UCSD-Quadcopter-Class/quad-hardware-bgmdt/quadcopter.brd

## EAGLE design quadcopter.brd (2017-05-23)

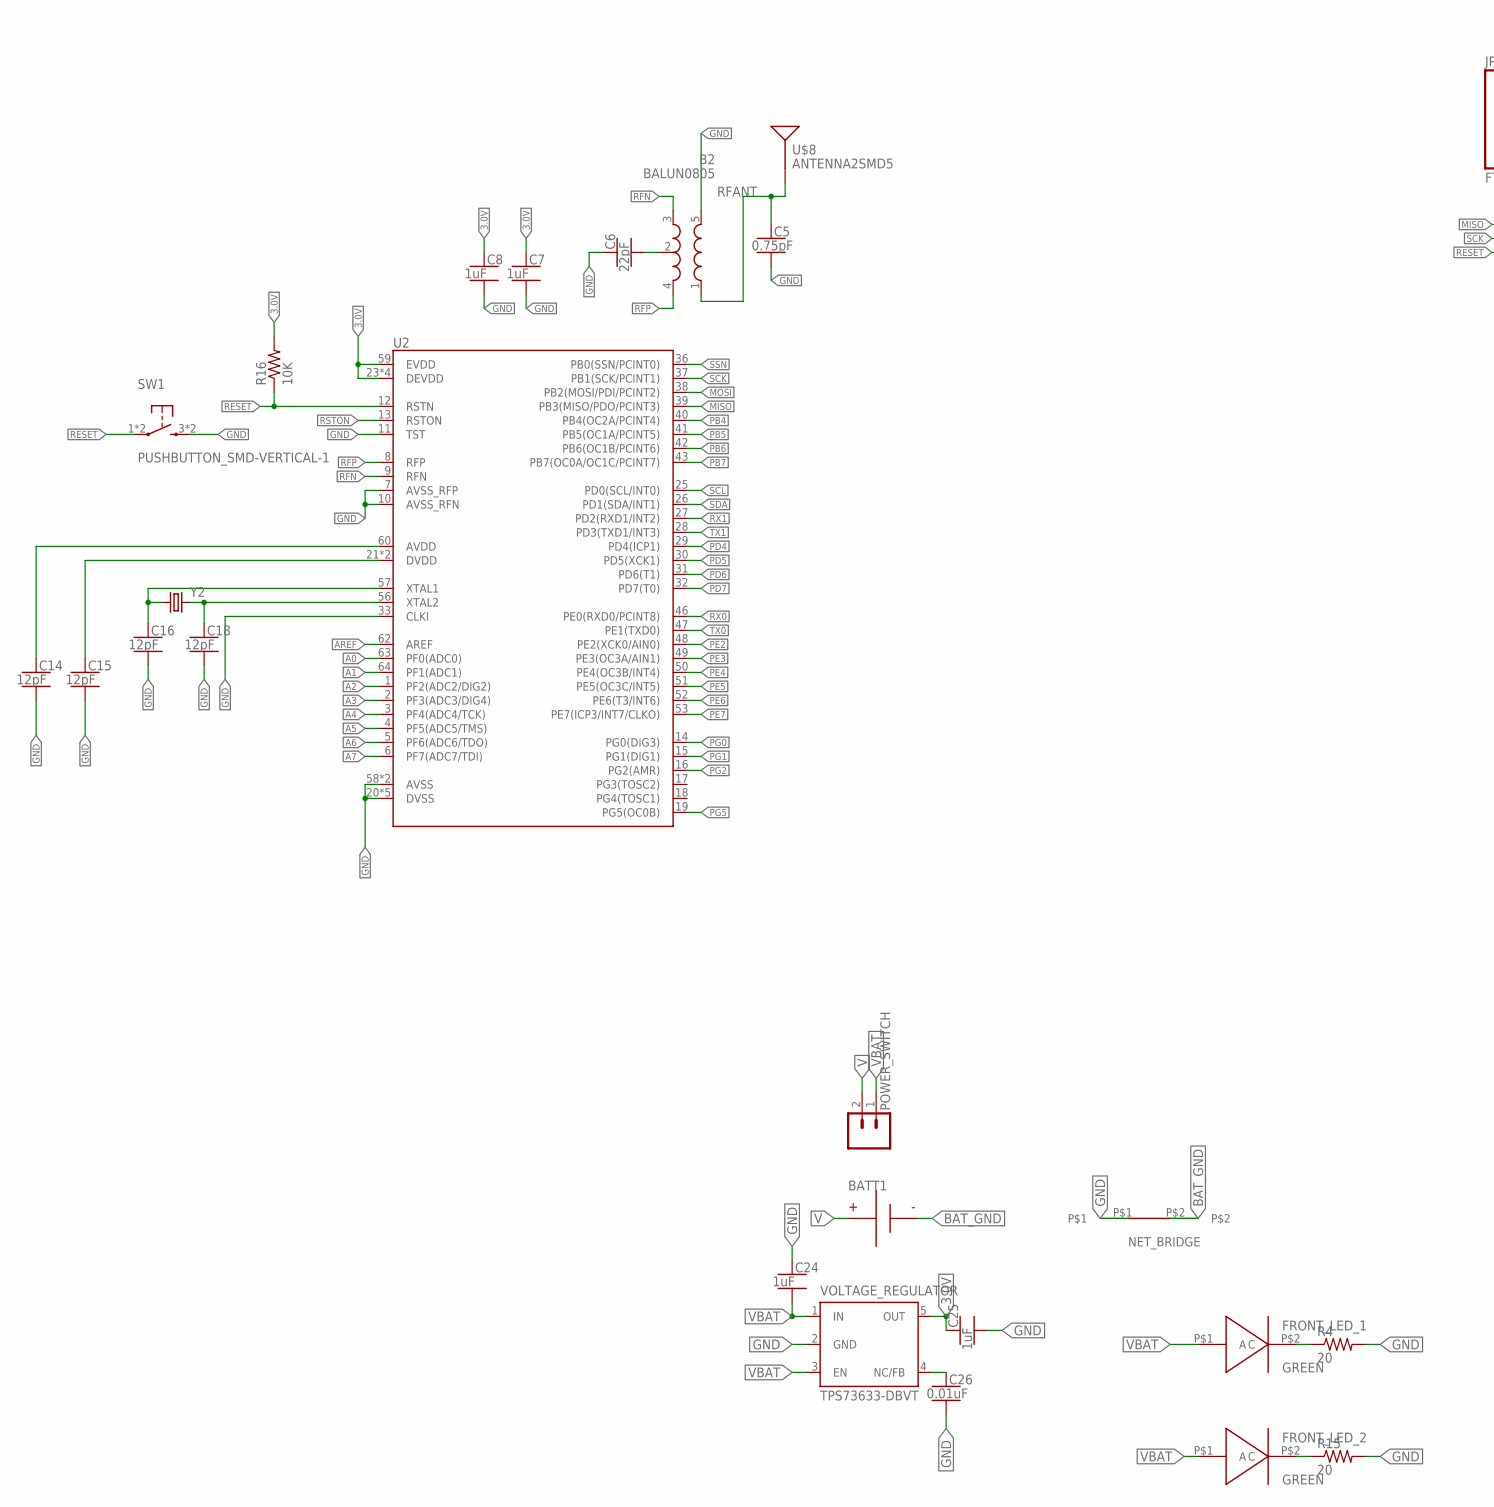
[picture p1: schematic quadcopter.sch, part in row 1, column 1]

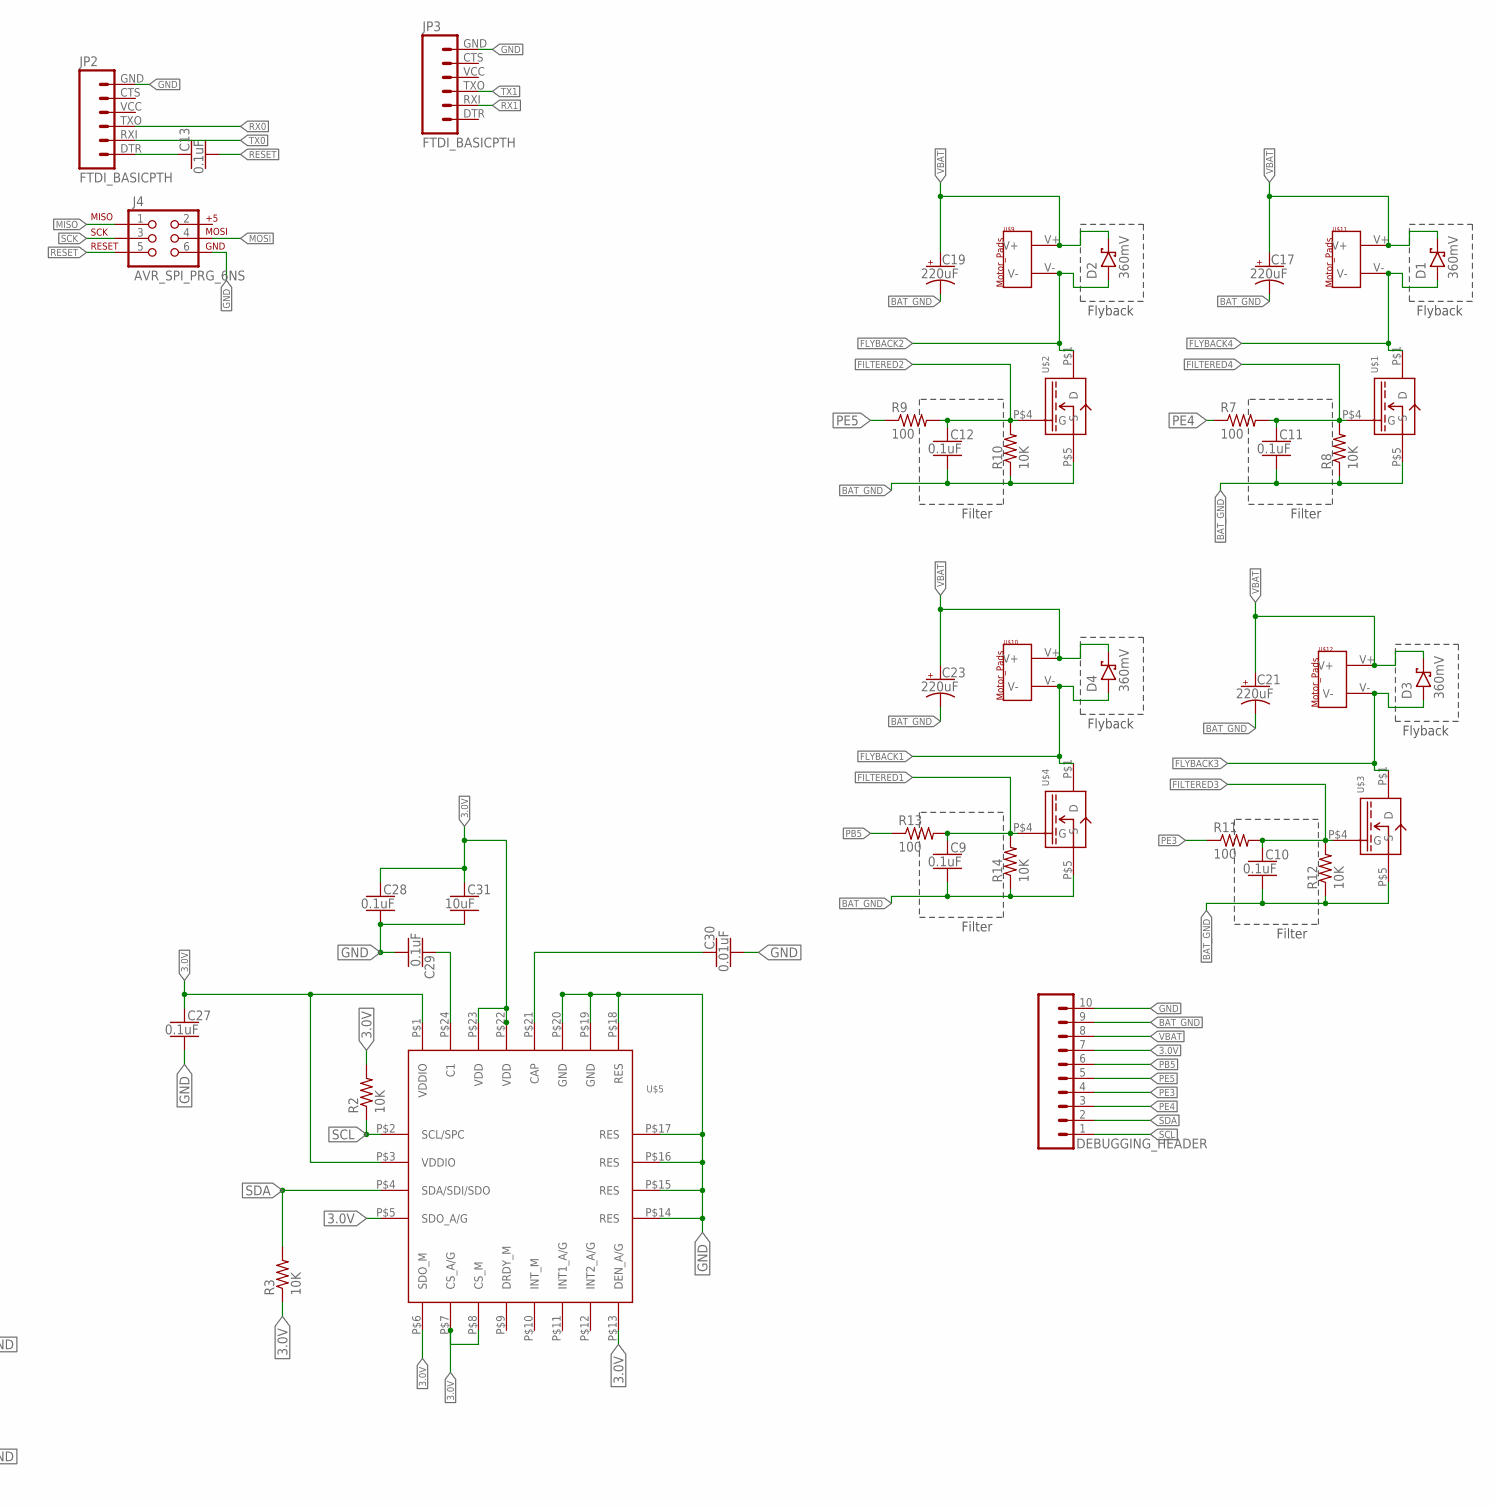
[picture p2: schematic quadcopter.sch, part in row 1, column 2]

Parts:
B2: BALUN0805; BALUN
BATT1: BATTERY-HUBSAN-W/HOLDER; BATTERY-W/HOLDER-380MAH-HUBSAN
C5: 0.75pF; CAPC2012X140_HS
C6: 22pF; CAPC2012X140_HS
C7, C8, C24, C25: 1uF; CAPC2012X140_HS
C9, C10, C11, C12, C13, C27, C28, C29: 0.1uF; CAPC2012X140_HS
C14, C15, C16, C18: 12pF; CAPC2012X140_HS
C17, C19, C21, C23: 220uF; CAPMP7343X310_HS
C26, C30: 0.01uF; CAPC2012X140_HS
C31: 10uF; CAPC2012X140_HS
D1, D2, D3, D4: 360mV; SOD3716X135_HS
DEBUGGING_HEADER: SIP-10_TH-254X10-1; HDRV10W63P254_10X1_2540X254H838_HS
FRONT_LED_1, FRONT_LED_2: GREEN; KINGBRIGHT_LED
J4: AVR_SPI_PRG_6NS; 2X3-NS
JP2, JP3: FTDI_BASICPTH; FTDI_BASIC
NET_BRIDGE: NET_BRIDGE
POWER_SWITCH: MALE_HEADER_2POS-2X1-0.1IN; MALE_HEADER_2X1_0.1IN
R2, R3, R8, R10, R12, R14, R16: 10K; RESC2012X60_HS
R4, R15: 20; RESC2012X60_HS
R7, R9, R11, R13: 100; RESC2012X60_HS
SW1: PUSHBUTTON_SMD-VERTICAL-1; TE_FSM8JSMA_HS
U2: ATMEGA128RFA1; QFN-64
U$1, U$2, U$3, U$4: MOFSET_SI2302CDS-T1-E3CT-ND
U$5: IMU_497-14946-1-ND
U$8: ANTENNA2SMD5; ANTENNA-CHIP5
U$9, U$10, U$11, U$12: MOTOR_PADS
VOLTAGE_REGULATOR: TPS73633-DBVT; SOT23-DBV
Y2: CRYSTAL5X3; CRYSTAL-SMD-5X3

Connections:
3.0V: C7.1, C8.1, C25.1, C27.1, C28.1, C31.1, DEBUGGING_HEADER.7, R2.2, R3.1, R16.2, U2.23 (DEVDD), U2.34 (DEVDD), U2.44 (DEVDD), U2.54 (DEVDD), U2.59 (EVDD), U$5.P$1 (VDDIO), U$5.P$3 (VDDIO), U$5.P$5 (SDO_A/G), U$5.P$6 (SDO_M), U$5.P$7 (CS_A/G), U$5.P$8 (CS_M), U$5.P$13 (DEN_A/G), U$5.P$22 (VDD), U$5.P$23 (VDD), VOLTAGE_REGULATOR.5 (OUT)
A0: U2.63 (PF0(ADC0))
A1: U2.64 (PF1(ADC1))
A2: U2.1 (PF2(ADC2/DIG2))
A3: U2.2 (PF3(ADC3/DIG4))
A4: U2.3 (PF4(ADC4/TCK))
A5: U2.4 (PF5(ADC5/TMS))
A6: U2.5 (PF6(ADC6/TDO))
A7: U2.6 (PF7(ADC7/TDI))
AREF: U2.62 (AREF)
AVDD: C14.1, U2.60 (AVDD); also elsewhere on the board
DTR: C13.1, JP2.DTR (1)
DVDD: C15.1, U2.21 (DVDD), U2.22 (DVDD); also elsewhere on the board
FILTERED1: C9.1, R13.2, R14.2, U$4.P$4 (G)
FILTERED2: C12.1, R9.2, R10.2, U$2.P$4 (G)
FILTERED3: C10.1, R11.2, R12.2, U$3.P$4 (G)
FILTERED4: C11.1, R7.2, R8.2, U$1.P$4 (G)
FLYBACK1: D4.A, U$4.P$1 (D), U$10.V-
FLYBACK2: D2.A, U$2.P$1 (D), U$9.V-
FLYBACK3: D3.A, U$3.P$1 (D), U$12.V-
FLYBACK4: D1.A, U$1.P$1 (D), U$11.V-
MISO: J4.1, U2.39 (PB3(MISO/PDO/PCINT3))
MOSI: J4.4, U2.38 (PB2(MOSI/PDI/PCINT2))
unnamed: FRONT_LED_1.P$2 (C), R4.1
unnamed: C30.1, U$5.P$21 (CAP)
unnamed: FRONT_LED_2.P$2 (C), R15.1
unnamed: B2.2 (GND), C6.2
unnamed: C29.1, U$5.P$24 (C1)
unnamed: C16.1, U2.57 (XTAL1), Y2.1
unnamed: C18.1, U2.56 (XTAL2), Y2.3 (2)
unnamed: C26.1, VOLTAGE_REGULATOR.4 (NC/FB)
PB4: U2.40 (PB4(OC2A/PCINT4))
PB5: DEBUGGING_HEADER.6, R13.1, U2.41 (PB5(OC1A/PCINT5))
PB6: U2.42 (PB6(OC1B/PCINT6))
PB7: U2.43 (PB7(OC0A/OC1C/PCINT7))
PD4: U2.29 (PD4(ICP1))
PD5: U2.30 (PD5(XCK1))
PD6: U2.31 (PD6(T1))
PD7: U2.32 (PD7(T0))
PE2: U2.48 (PE2(XCK0/AIN0))
PE3: DEBUGGING_HEADER.4, R11.1, U2.49 (PE3(OC3A/AIN1))
PE4: DEBUGGING_HEADER.3, R7.1, U2.50 (PE4(OC3B/INT4))
PE5: DEBUGGING_HEADER.5, R9.1, U2.51 (PE5(OC3C/INT5))
PE6: U2.52 (PE6(T3/INT6))
PE7: U2.53 (PE7(ICP3/INT7/CLKO))
PG0: U2.14 (PG0(DIG3))
PG1: U2.15 (PG1(DIG1))
PG2: U2.16 (PG2(AMR))
PG5: U2.19 (PG5(OC0B))
RESET: C13.2, J4.5, R16.1, SW1.1, SW1.2 (1), U2.12 (RSTN)
RFANT: B2.1 (IN), C5.1, U$8.FEED
RFN: B2.3 (OUT2), U2.9 (RFN)
RFP: B2.4 (OUT1), U2.8 (RFP)
RSTON: U2.13 (RSTON)
RX0: JP2.TXO (3), U2.46 (PE0(RXD0/PCINT8))
SCK: J4.3, U2.37 (PB1(SCK/PCINT1))
SCL: DEBUGGING_HEADER.1, R2.1, U2.25 (PD0(SCL/INT0)), U$5.P$2 (SCL/SPC)
SDA: DEBUGGING_HEADER.2, R3.2, U2.26 (PD1(SDA/INT1)), U$5.P$4 (SDA/SDI/SDO)
SSN: U2.36 (PB0(SSN/PCINT0))
TX0: JP2.RXI (2), U2.47 (PE1(TXD0))
V: BATT1.+, POWER_SWITCH.2
VBAT: C17.1 (+), C19.1 (+), C21.1 (+), C23.1 (+), C24.2, D1.C, D2.C, D3.C, D4.C, DEBUGGING_HEADER.8, FRONT_LED_1.P$1 (A), FRONT_LED_2.P$1 (A), POWER_SWITCH.1, U$9.V+, U$10.V+, U$11.V+, U$12.V+, VOLTAGE_REGULATOR.1 (IN), VOLTAGE_REGULATOR.3 (EN)

Notes on the sheet:
Filter
Flyback

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
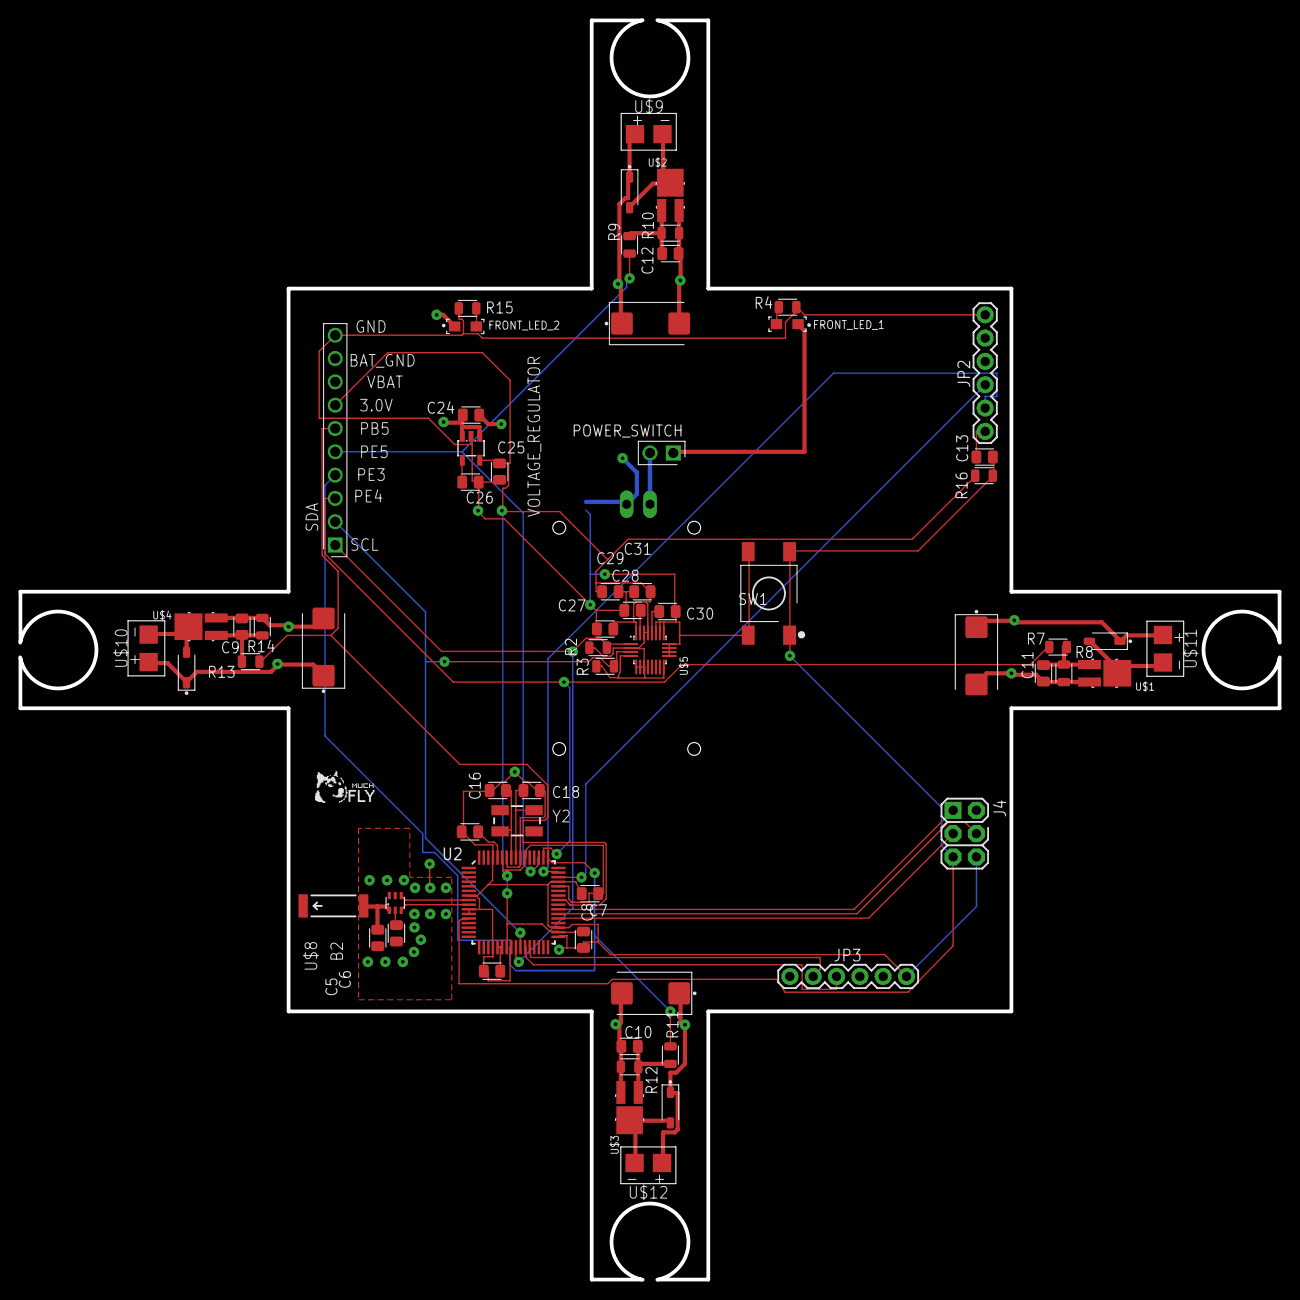
[picture p3: board quadcopter.brd from above]

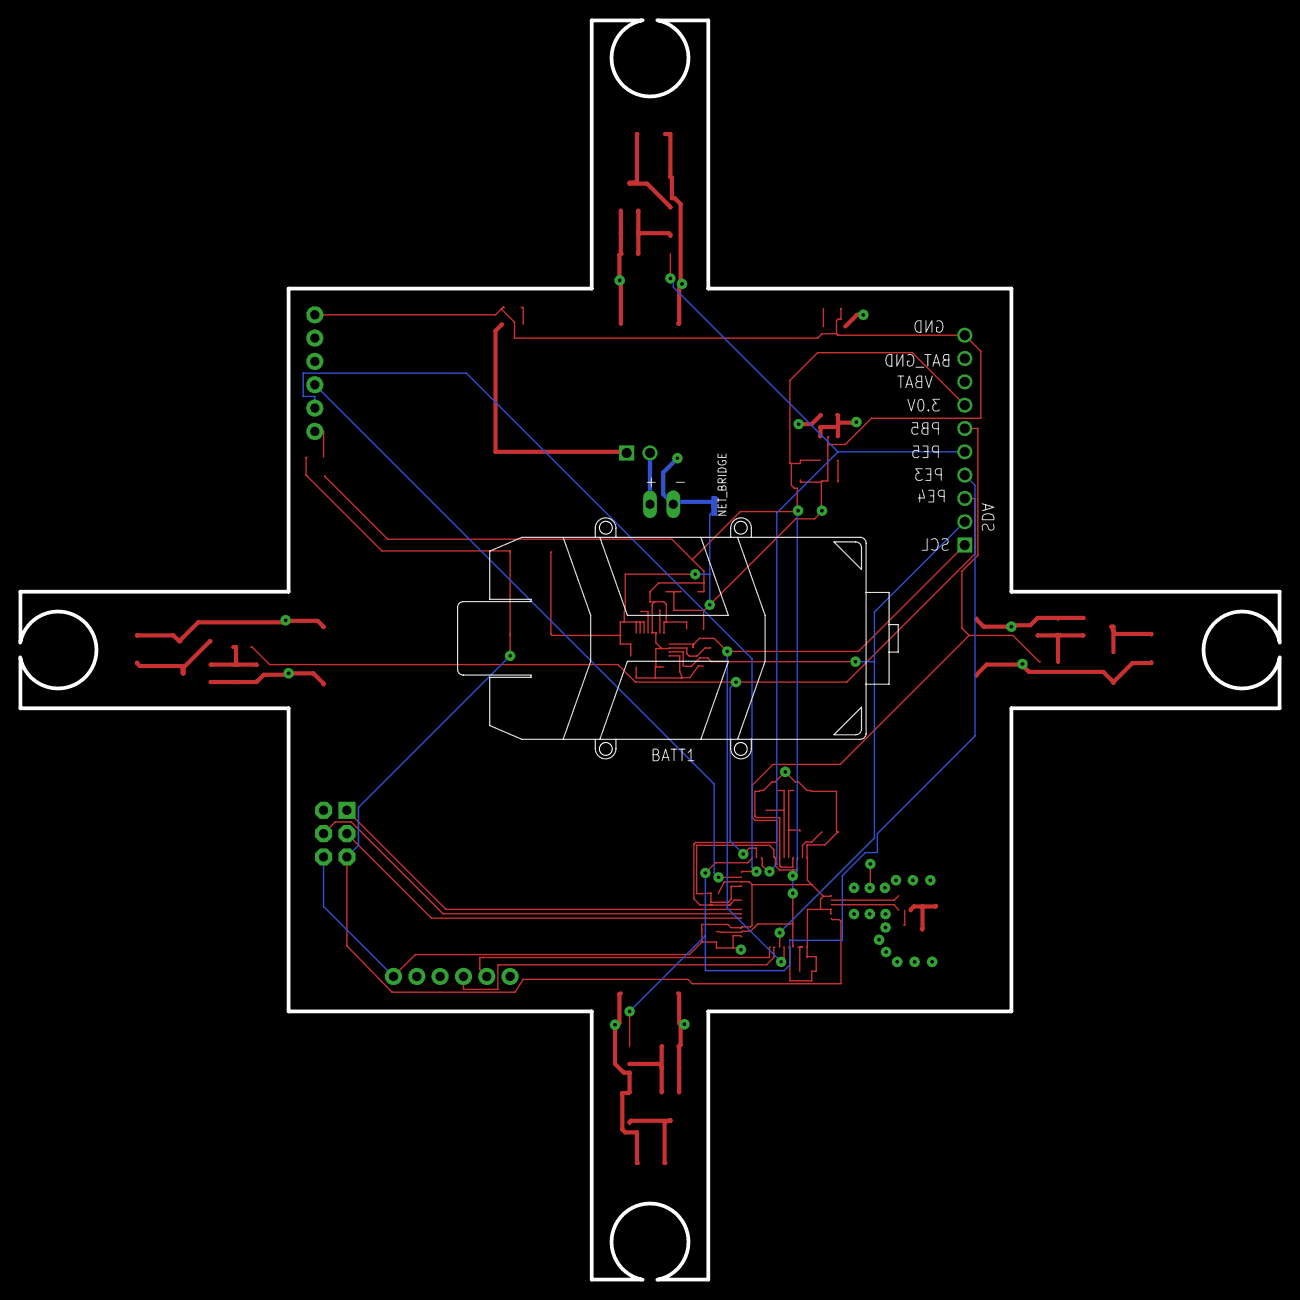
[picture p4: board quadcopter.brd from below]

Board: 4 copper layers, 137.2 x 137.2 mm, 67 parts (2 on the bottom side), 41 nets.

Other parts of the board:
C1, C2: 1uF; CAPC2012X140_HS
U$7: DOGE

Their connections:
AVDD: C1.1; also elsewhere on the board
DVDD: C2.1; also elsewhere on the board
