UCSD-Quadcopter-Class/quad-hardware-bgmdt/(commit log)

2016-04-21 Removing StaringPoint.sh
    [StartingPoint.sch]
2016-04-28 Package with motor geometry
    [StartingPoint.sch]
2017-04-10 Added motor driver schematic
    [Motor-Driver.sch]
2017-04-19 Place microcontroller and motors
    [quadcopter.brd, quadcopter.sch]
2017-04-19 voltage reg added
    [quadcopter.brd, quadcopter.sch]
2017-04-19 Finish MC, Breakout, and Motors
    [quadcopter.sch]
2017-04-19 IMU finished, LED lib added but empty
    [quadcopter.sch]
2017-04-19 Added LEDs into schematic in series, no resistor necessary
    [quadcopter.sch]
2017-04-20 Added supporting docs for LEDs
2017-04-20 Everything seems to be in order
    [quadcopter.sch]
2017-04-24 Lab4b I
    [quadcopter.sch]
2017-04-25 Added pull up resistors, fixed leds
    [quadcopter.sch]
2017-04-26 Fix quadcopter shematic and parts in quadcopter_jay
    [quadcopter.sch]
2017-04-27 Added all parts to board but have yet to run autorouter/set up the traces
    [quadcopter.brd, quadcopter.sch]
2017-04-27 instructior review of original schematic
2017-04-27 Fixed some schematic things, still need to fix swanson notes and the motor drivers
    [quadcopter.brd, quadcopter.sch]
2017-05-01 Modify Motor Driver and check off components on swanson_design_review
    [quadcopter.brd, quadcopter.sch]
2017-05-02 Finish Board Layers (still need to route
    [quadcopter.brd, quadcopter.sch]
2017-05-03 Push Board
    [quadcopter.brd]
2017-05-03 Ran Autorouter but did not fix errros
    [quadcopter.brd]
2017-05-03 added motor holes
    [quadcopter.brd]
2017-05-04 Design Review -- Board
    [quadcopter.brd, quadcopter.sch]
2017-05-11 Board is done
    [quadcopter.brd, quadcopter.sch]
2017-05-16 Finished Board (again)
    [quadcopter.brd, quadcopter.sch]
2017-05-16 Move Caps closer to microcontroller
    [quadcopter.brd]
2017-05-16 Almost Completely Done
    [quadcopter.brd, quadcopter.sch]
2017-05-16 Finalize Board (Add Reviewers)
2017-05-16 Forgot to approve stop mask errors
    [quadcopter.brd]
2017-05-16 more schematic comments from swanson
2017-05-19 Current Additions
2017-05-23 New Revision
    [quadcopter.brd, quadcopter.sch]
2017-05-23 Board finally passes DFM
    [quadcopter.brd]
2017-05-23 Update board_review_swanson.txt
    Comment on diodes.
2017-05-23 Add Everything
    [quadcopter.brd, quadcopter.sch]
2017-05-23 Passing DFM again
    [quadcopter.sch]
2017-05-23 Update CAM Files
    [quadcopter.brd]
2017-05-23 Whoops, deleted quadcopter schematic
    [quadcopter.sch]
